Technische-Natuurkunde-HvA/inverted-pendulum-team-3/visuals/figures/Flowchart_upside_down/Flowchart_upside_down.jpeg

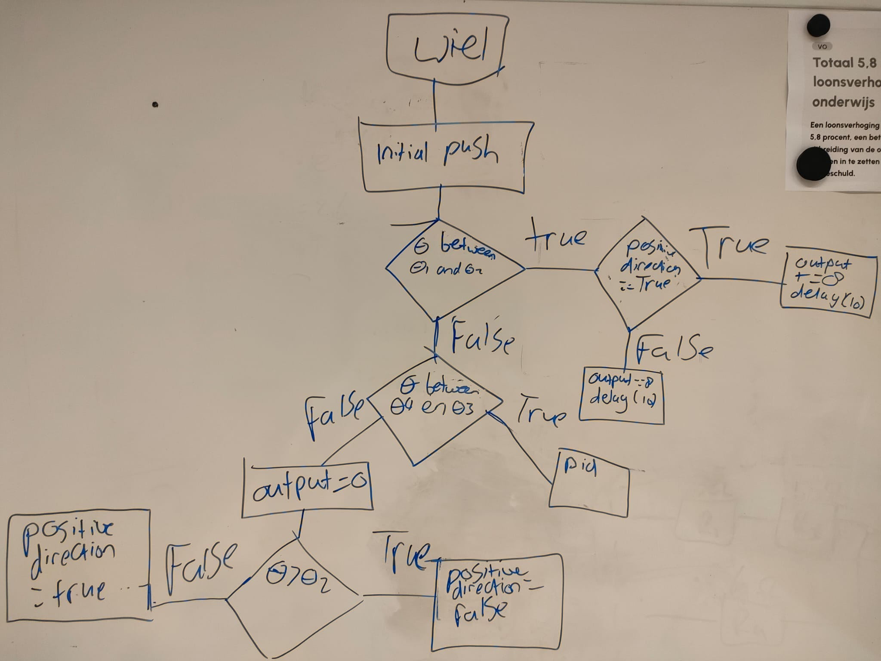
visuals/figures/Flowchart_upside_down/Flowchart_upside_down.jpeg
