Technische-Natuurkunde-HvA/inverted-pendulum-team-3/visuals/figures/Flowchart_upside_down/FlowChartDigital.png

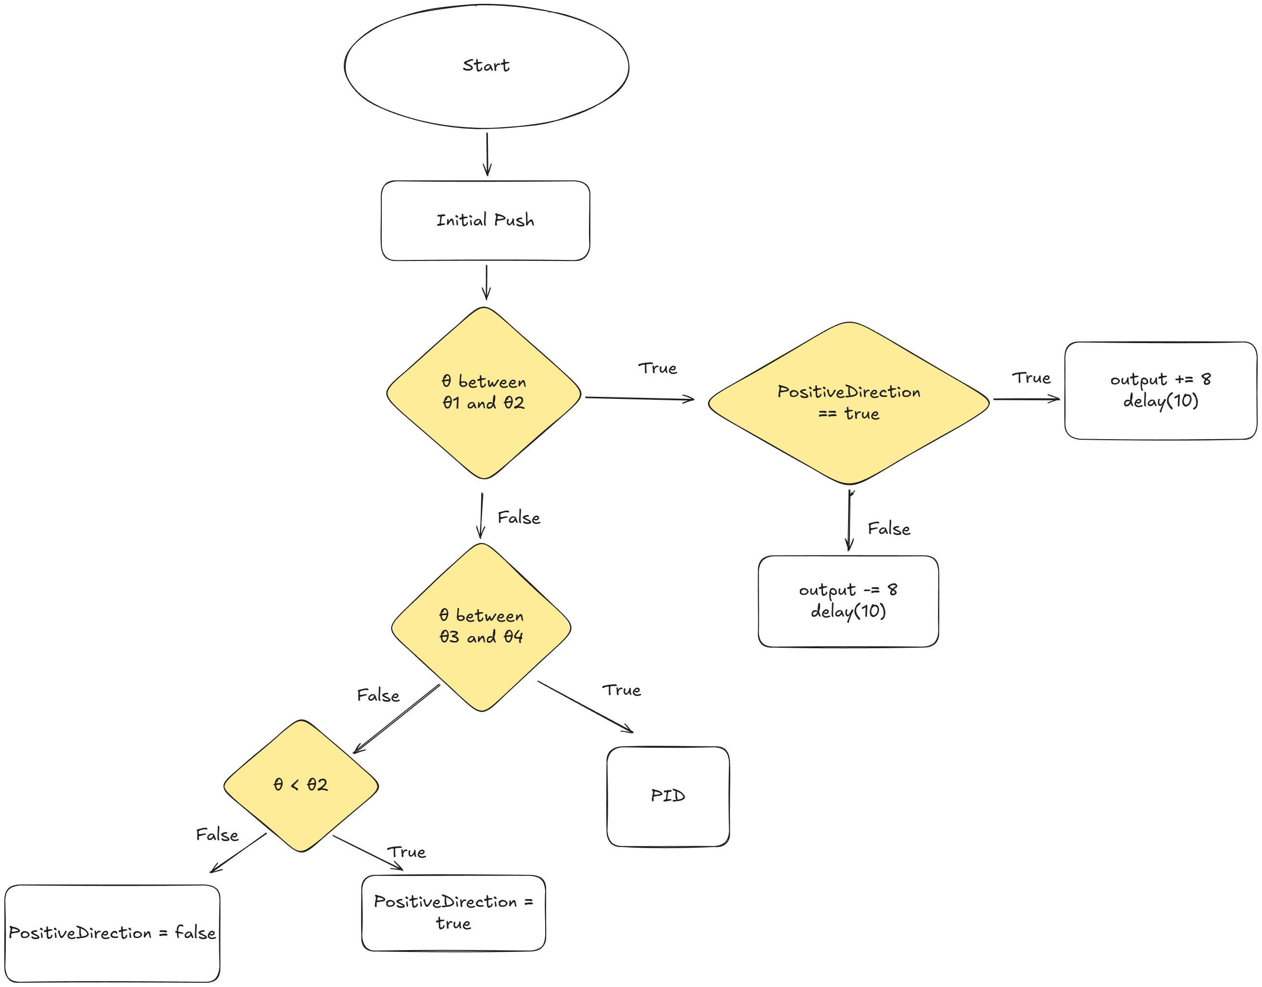
visuals/figures/Flowchart_upside_down/FlowChartDigital.png
