Technische-Natuurkunde-HvA/inverted-pendulum-team-3/visuals/figures/Flowchart_upside_down/Support_for_flowchart.jpeg

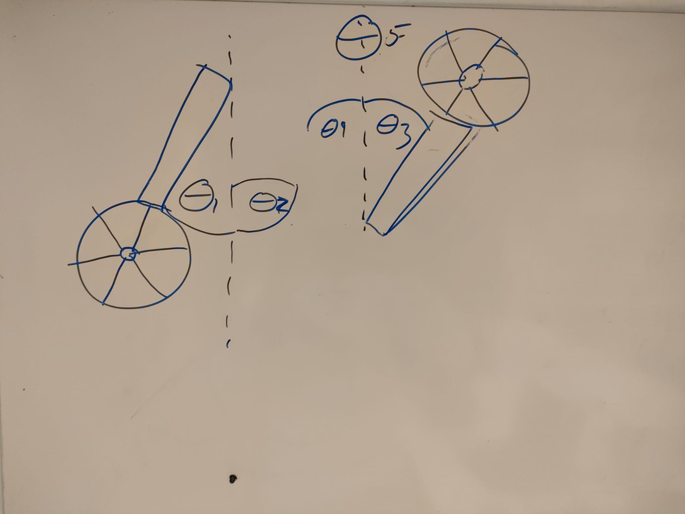
visuals/figures/Flowchart_upside_down/Support_for_flowchart.jpeg
