Technische-Natuurkunde-HvA/inverted-pendulum-team-3/visuals/figures/FlowChartV1.jpeg

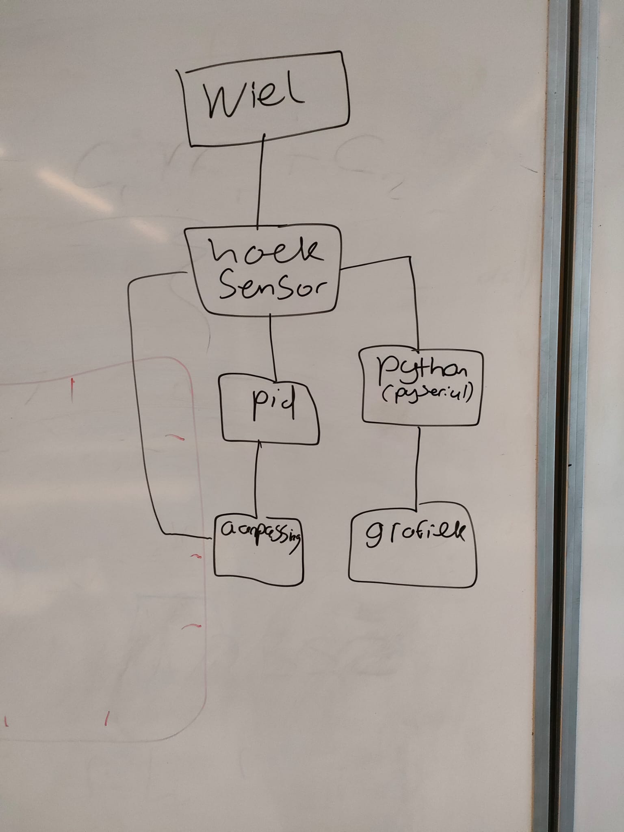
visuals/figures/FlowChartV1.jpeg
