Technische-Natuurkunde-HvA/inverted-pendulum-team-3/code/Arduino/Swing_pendulum_simple/Swing_pendulum_simple.ino

#include <Wire.h>
#include <AS5600.h>
AS5600  as5600;  //create sensor object
unsigned long currentMs;  //current time variable
unsigned long lastMs;     // time of last measurement
const unsigned int FREE_RUN_PERIOD_MS = 100; //sampling period
float sig_angle_deg;  // angle measurement

// Motor control pins
const int motorPin1 = 10; // IN1
const int motorPin2 = 11; // IN2
const int enablePin = 9; // ENA (PWM pin for speed control)

double output; 

void readAndPrintAngle();

void setup() {
  // Set motor control pins as outputs
  pinMode(motorPin1, OUTPUT);
  pinMode(motorPin2, OUTPUT);
  pinMode(enablePin, OUTPUT);

  digitalWrite(motorPin1, LOW);
  digitalWrite(motorPin2, HIGH);

  output = 0 ; 
  
  Wire.begin();     // Initialize I2C
  as5600.begin();   // Initialize sensor
  lastMs= millis();   // Initialize timing
  Serial.begin(9600);  // Initialize Serial Monitor
  delay(2000);
  Serial.print("Test: ");
  Serial.println();

}

void loop() {
  currentMs = millis();
  // checks if the pendulum is on 1 side and pushes it
 if (sig_angle_deg > 230 && output < 200){
    output = output + 8;
    delay(10);
  }
  // checks if its nearing the top and slows it down
  else if (sig_angle_deg >= 230 && sig_angle_deg <= 260 && output > 0){
    output = output - 2;
    delay(5);
  }
  else if (sig_angle_deg < 260 && ouput >-200){
    // use output bigger or smaller then 0 basically its spinning in the opposite direction.
    output = output -8 ;
    delay(10)
  }

  analogWrite(enablePin, abs(output));
}

void readAndPrintAngle() {
      lastMs = currentMs;
      sig_angle_deg = (float)as5600.readAngle()*0.0879; //0.0879=360/4096;  // degrees [0..360)
      Serial.print(sig_angle_deg); Serial.print('\t');
      Serial.println();    
}
