Technische-Natuurkunde-HvA/inverted-pendulum-team-3/(commit log)

2025-11-20 Added an improved outputresponsecurve with code and some small QoL changes to the motor code.
2025-11-21 I tested a pyserial connection and it worked
    Will integrate it to the motor code later
2025-11-22 Integrated the Angle sensor code and pyserial connection
2025-11-23 Put a Pid controller on and declared the inputs and the PID values
2025-11-27 Added the PID controller to our code
2025-11-27 Moved the arduino files to an arduino folder
2025-11-30 Reverted to the code without the PID since this is what we used to test the motor
    [Motor_encoder_simple.ino]
2025-11-30 Added the PID code to this file and integrated our other file properly.
2025-11-30 Updated the weekly update with the PID code and the python code.
2025-12-02 minor fixes/changes
    1. corrected the way the angles are printed. 2. changed the setpoint to the new desired angle after (remounting the angle sensor) 3. changed the PID parameters
    [PIDController.ino, Swing_pendulum_simple.ino]
2025-12-05 Updated Results
    [data_24-11-2025_10-57.csv, data_24-11-2025_11-02.csv, data_24-11-2025_11-32.csv, data_25-11-2025_12-56.csv, data_25-11-2025_13-08.csv, data_25-11-2025_13-09.csv]
2025-12-10 Added Flowchart and an example video of the upsidedown challenge
2025-12-13 First measurement data
    [DataUpsideDownMeting.csv]
2025-12-13 Updated the Arduino code explanation
2025-12-13 added the right CSV file
    [DataUpsideDown.csv]
2025-12-13 Update and rename DataUpsideDown.csv to DataUpsideDownFinal.csv
    [DataUpsideDownFinal.csv]
2025-12-14 Made a digital version of our first flowchart
2025-12-14 Renamed the folder upside down flowchart to upside_down_flowchart so we can reference it in MD
2025-12-14 Updated the flowchart language
